Noodle-Box/Multimeter_TP1/README.md

# Multimeter---Team-Project-I
Multimeter for ENGG2800 - Team Project I

Features:
- DC Voltage
- AC Voltage
- Continuity (Current)
- Impedance

ENGG2800_Schematic_Multimeter
