Noodle-Box/Multimeter_TP1/PRODUCT_BOM.xlsx

Designator | Description | Quantity | Price each | Total price | Manufacturer | Manufacturer # | Supplier | Supplier # | RoHS link | RoHS notes
R22 | RESISTOR: 0.6 Watt/560 ohm/1%/Through Hole Resistor/Axial | 1 | $0.14 | $0.14 | Vishay Intertechnology | MRS25000C5607FCT | ETSG | Bin 02-23-01 | https://etsgstore.uqcloud.net/ | Compliance on Datasheet
R11,R16,R20 | RESISTOR: 0.6 Watt/1 Kohm/1%/Through Hole Resistor/Axial | 3 | $0.09 | $0.27 | Vishay Intertechnology | MRS25000C1001FCT | ETSG | Bin 02-25-02 | https://etsgstore.uqcloud.net/ | Compliance on Datasheet
R1,R2,R3,R6,R7,R9,R10,R13,R15,R18,R19 | RES 10K OHM 5% 1/4W AXIAL | 11 | $0.14 | $1.54 | Stackpole Electronics Inc | CF14JT10K0 | Digkey | CF14JT10K0CT-ND | https://www.digikey.com.au/en/products/detail/stackpole-electronics-inc/CF14JT10K0/1741265
R8,R14 | RESISTOR: 0.6 Watt/15 Kohm/1%/Through Hole Resistor/Axial | 2 | $0.16 | $0.32 | Vishay Intertechnology | MRS25000C51502FCT | Digikey | Bin 02-34-03 | https://etsgstore.uqcloud.net/ | Compliance on Datasheet
R4,R5 | RESISTOR: 0.6 Watt/27 Kohm/1%/Through Hole Resistor/Axial | 2 | $0.06 | $0.12 | Vishay Intertechnology | MRS25000C2702FCT | ETSG | Bin 02-36-03 | https://etsgstore.uqcloud.net/ | Compliance on Datasheet
R12,R17 | RESISTOR: 0.6 Watt/30 Kohm/1%/Through Hole Resistor/Axial | 2 | $0.04 | $0.08 | Vishay Intertechnology | MRS25000C3002FCT | ETSG | Bin 02-37-01 | https://etsgstore.uqcloud.net/ | Compliance on Datasheet
R21 | RESISTOR: 0.6 Watt/100 Kohm/1%/Through Hole Resistor/Axial | 1 | $0.02 | $0.02 | Vishay Intertechnology | MRS25000C1003FCT | ETSG | Bin 02-41-02 | https://etsgstore.uqcloud.net/ | Compliance on Datasheet
C1,C2 | CAPACITOR: Through Hole/Ceramic/100n/50V/High K / Y5U | 2 | $0.10 | $0.20 | Multicomp-Pro | MC0805Y104K5002.54MM | ETSG | Bin 03-12-02 | https://etsgstore.uqcloud.net/ | Compliance on Datasheet
- | BATTERIES : Battery / 1V5 / AA Style / Alkaline / 1.5v | 3 | 0.29 | 0.87 | Energizer Battery Company | 815 BULKJ2 | ETSG | Bin 28-09-02 | https://www.digikey.com.au/en/products/detail/energizer-battery-company/815-BULKJ2/11615679 | Same product from ETSG
- | BATT HOLDER AA 3 CELL 6" LEADS | 1 | 2.45 | 2.45 | Keystone Electronics | 2465 | Digikey | 36-2465-ND | https://www.digikey.com.au/en/products/detail/keystone-electronics/2465/303814
Batt1 | CONN HEADER R/A 2POS 2MM | 1 | 0.24 | 0.24 | JST Sales America Inc. | S2B-PH-K-S(LF)(SN) | Digikey | 455-1719-ND | https://www.digikey.com.au/en/products/detail/jst-sales-america-inc/S2B-PH-K-S-LF-SN/926626
- | CONN HOUSING PH 2POS 2MM WHITE | 1 | 0.14 | 0.14 | JST Sales America Inc. | PHR-2 | Digikey | 455-1165-ND | https://www.digikey.com.au/en/products/detail/jst-sales-america-inc/PHR-2/608607
- | CONNECTOR : JST PH - Crimp Terminal / Use Crimp Tool K143 | 2 | 0.02 | 0.04 | JST Sales America Inc. | SPH-002T-P0.5S | ETSG | Bin 08-50-03 | https://etsgstore.uqcloud.net/ | Compliance from Supplier
SW1,SW2,SW3,SW4,SW5 | SWITCH : PCB Mount / Tactile / 0.05A, 24VDC / SPST-NO | 6 | 0.14 | 0.84 | TE Connectivity | 1825910-6 | ETSG | Bin 04-69-03 | https://etsgstore.uqcloud.net/ | Compliance on Datasheet
SW6 | Slide Switch SPDT Through Hole | 1 | 1.25 | 1.25 | CUI Devices | MSS-102559-14A-D | Digikey | 2223-MSS-102559-14A-D-ND | https://www.digikey.com.au/en/products/detail/cui-devices/MSS-102559-14A-D/13978983
J1,J3 | 4mm Panel Mount Banana Socket - Red (BULK) | 1 | 6.84 | 6.84 | Staubli | 23.3000-22 | RS - Online | 404-171 | https://au.rs-online.com/web/p/banana-connectors/0404171
J2,J4 | 4mm Panel Mount Banana Socket - Black (BULK) | 1 | 6.84 | 6.84 | Staubli | 23.3000-21 | RS - Online | 404-137 | https://au.rs-online.com/web/p/banana-connectors/0404137/
U4 | IC MCU 8BIT 32KB FLASH 28DIP | 1 | 3.5 | 3.5 | Microchip Technology | ATMEGA328P-PU | Mouser | 556-ATMEGA328P-PU | https://au.mouser.com/ProductDetail/Microchip-Technology-Atmel/ATMEGA328P-PU
U1 | IC OPAMP JFET 4 CIRCUIT 14DIP | 1 | 1.46 | 1.46 | NJR Corporation/NJRC | NJM064D | Mouser | 513-NJM064D | https://au.mouser.com/ProductDetail/NJR/NJM064D
U6 | SEEEDIUNO XIAO - SAMD21 Cortex M0+ | 1 | 5.4 | 5.4 | Seeeduino Studio | Seeeduino XIAO | Seeeduino Studio | Seeeduino XIAO | https://www.seeedstudio.com/Seeeduino-XIAO-Arduino-Microcontroller-SAMD21-Cortex-M0+-p-4426.html
U3 | Adafruit 6-pin AVR ISP Breadboard Adapter Mini Kit | 1 | 0.95 | 0.95 | Adafruit | Adafruit 6-pin AVR ISP | Adafruit | Adafruit 6-pin AVR ISP | https://www.adafruit.com/product/1465
U2 | Pololu 3.3V Step-Up Voltage Regulator U1V10F3 | 1 | 7.35 | 7.35 | Pololu | U1V10F3 | Pololu | U1V10F3 | https://www.pololu.com/product/2563
DISP1 | Small Size Blue LCD Bezel 20x4 Arduino Library Character Display Module | 1 | 6.26 | 6.26 | EastRising | ERM2004SBS-3 | BuyDisplay | ERM2004SBS-3 | https://www.buydisplay.com/small-size-blue-lcd-bezel-20x4-arduino-library-character-display-module
U5 | ADS1115 16BIT ADC 4CH PROG GAIN | 1 | 20.18 | 20.18 | Adafruit | 1085 | Mouser | 485-1085 | https://au.mouser.com/ProductDetail/Adafruit/1085?qs=GURawfaeGuCW8oufi8WauA%3D%3D
- | PCB Pinecone | 1 | $32.50 | $32.50
 |  |  | Total: | $99.80
