Noodle-Box/Multimeter_TP1/Multimeter Schematics.pdf

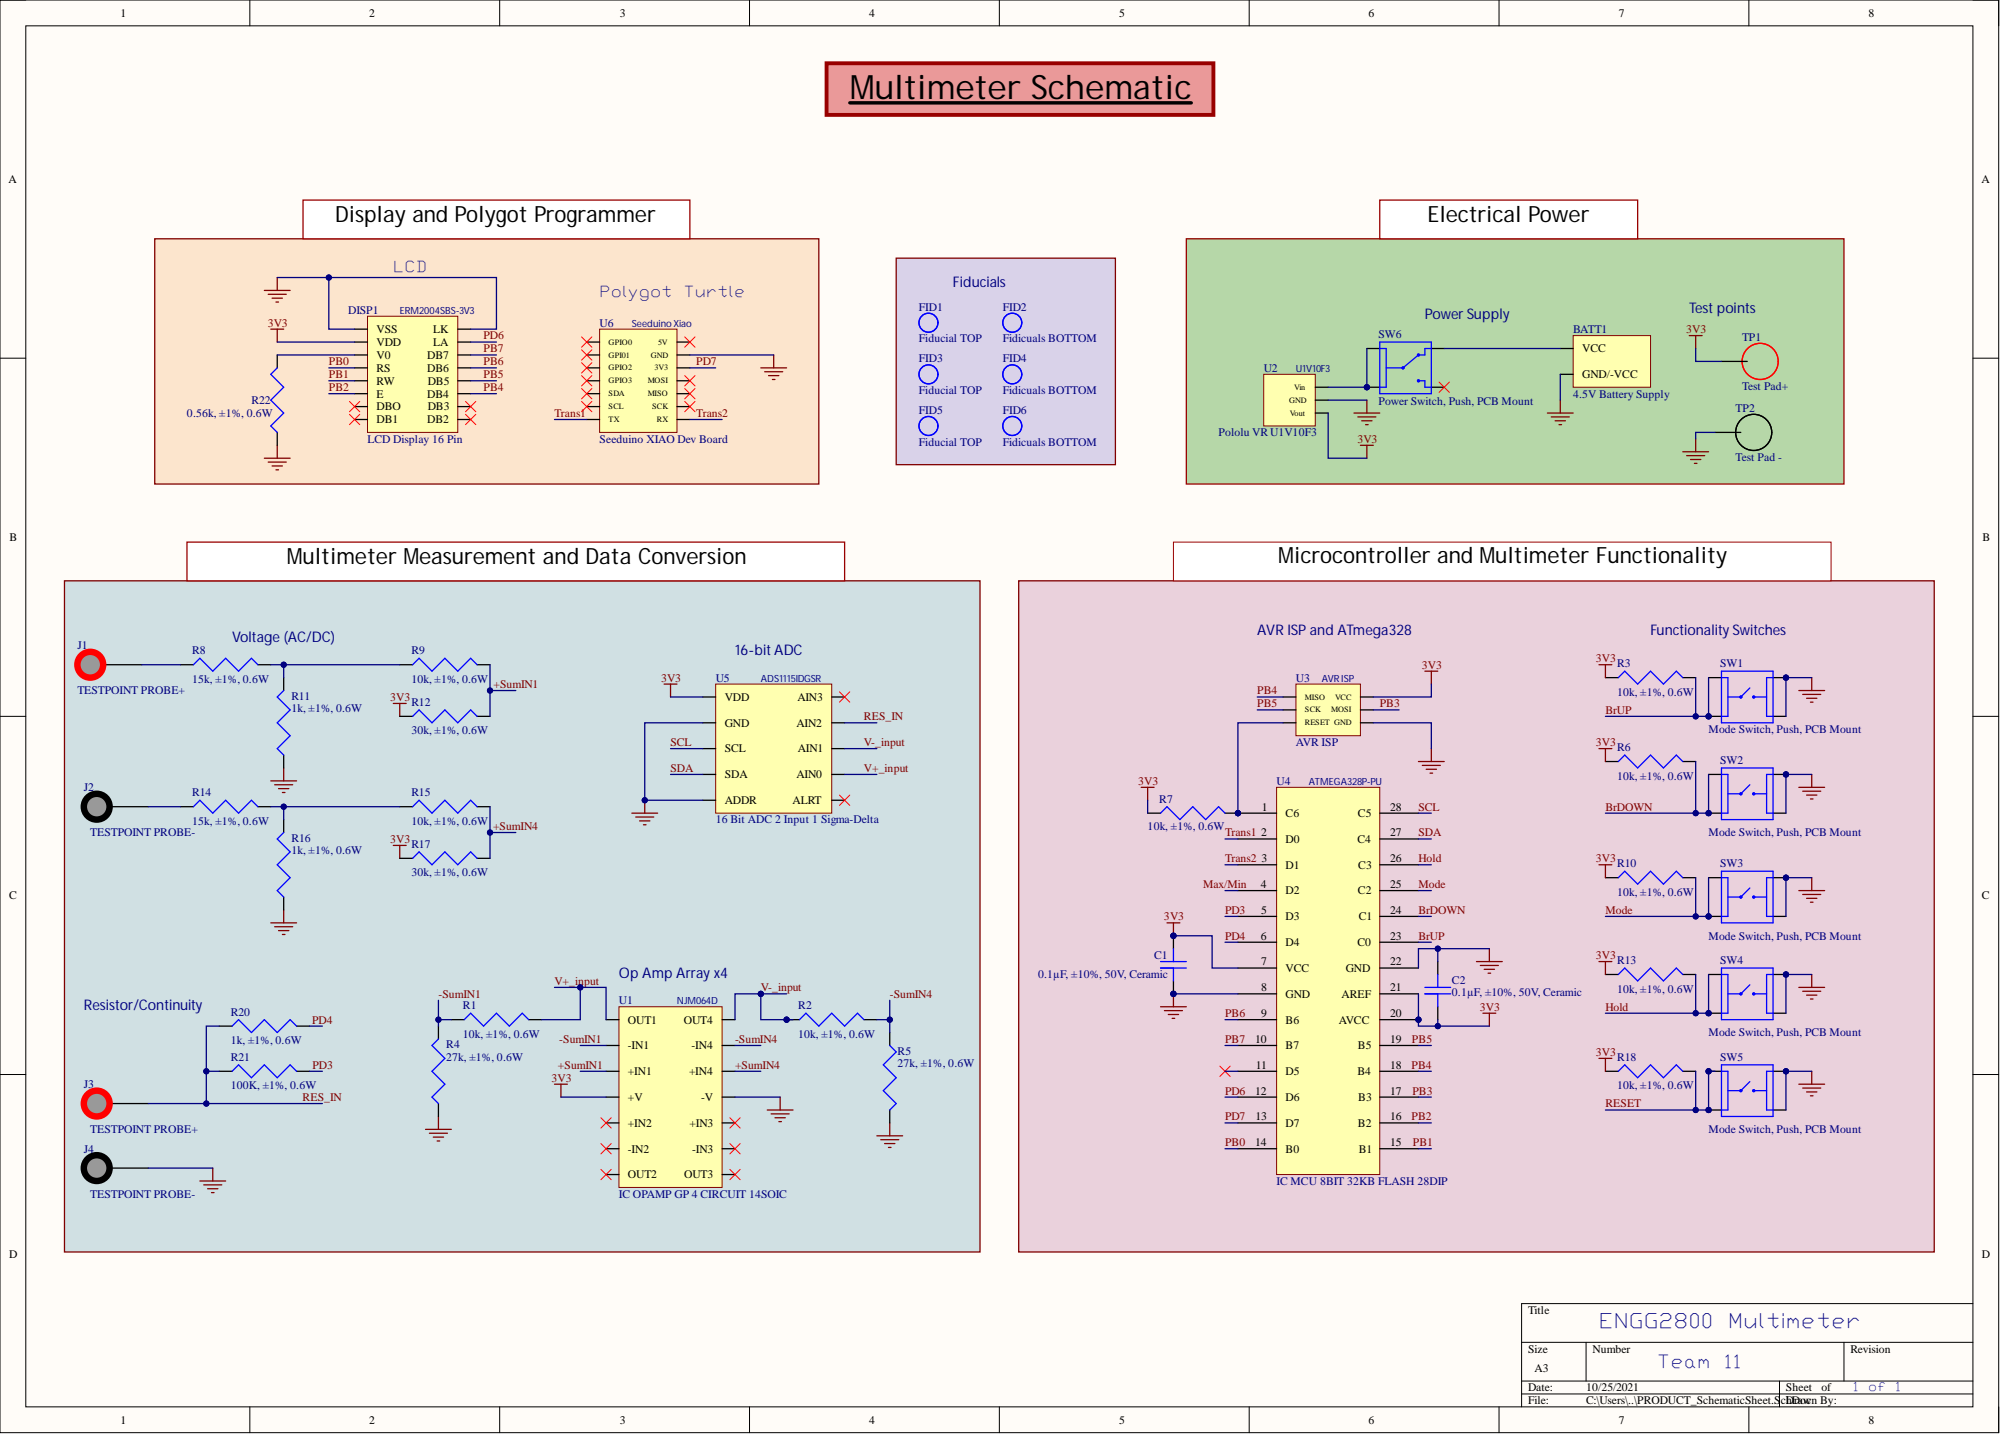
[picture p1: page 1]

Power Switch, Push, PCB Mount

Mode Switch, Push, PCB Mount

16 Bit ADC 2 Input 1 Sigma-Delta

IC OPAMP GP 4 CIRCUIT 14SOIC
