Noodle-Box/Multimeter_TP1/Multimeter Layers (Top and Bottom).pdf

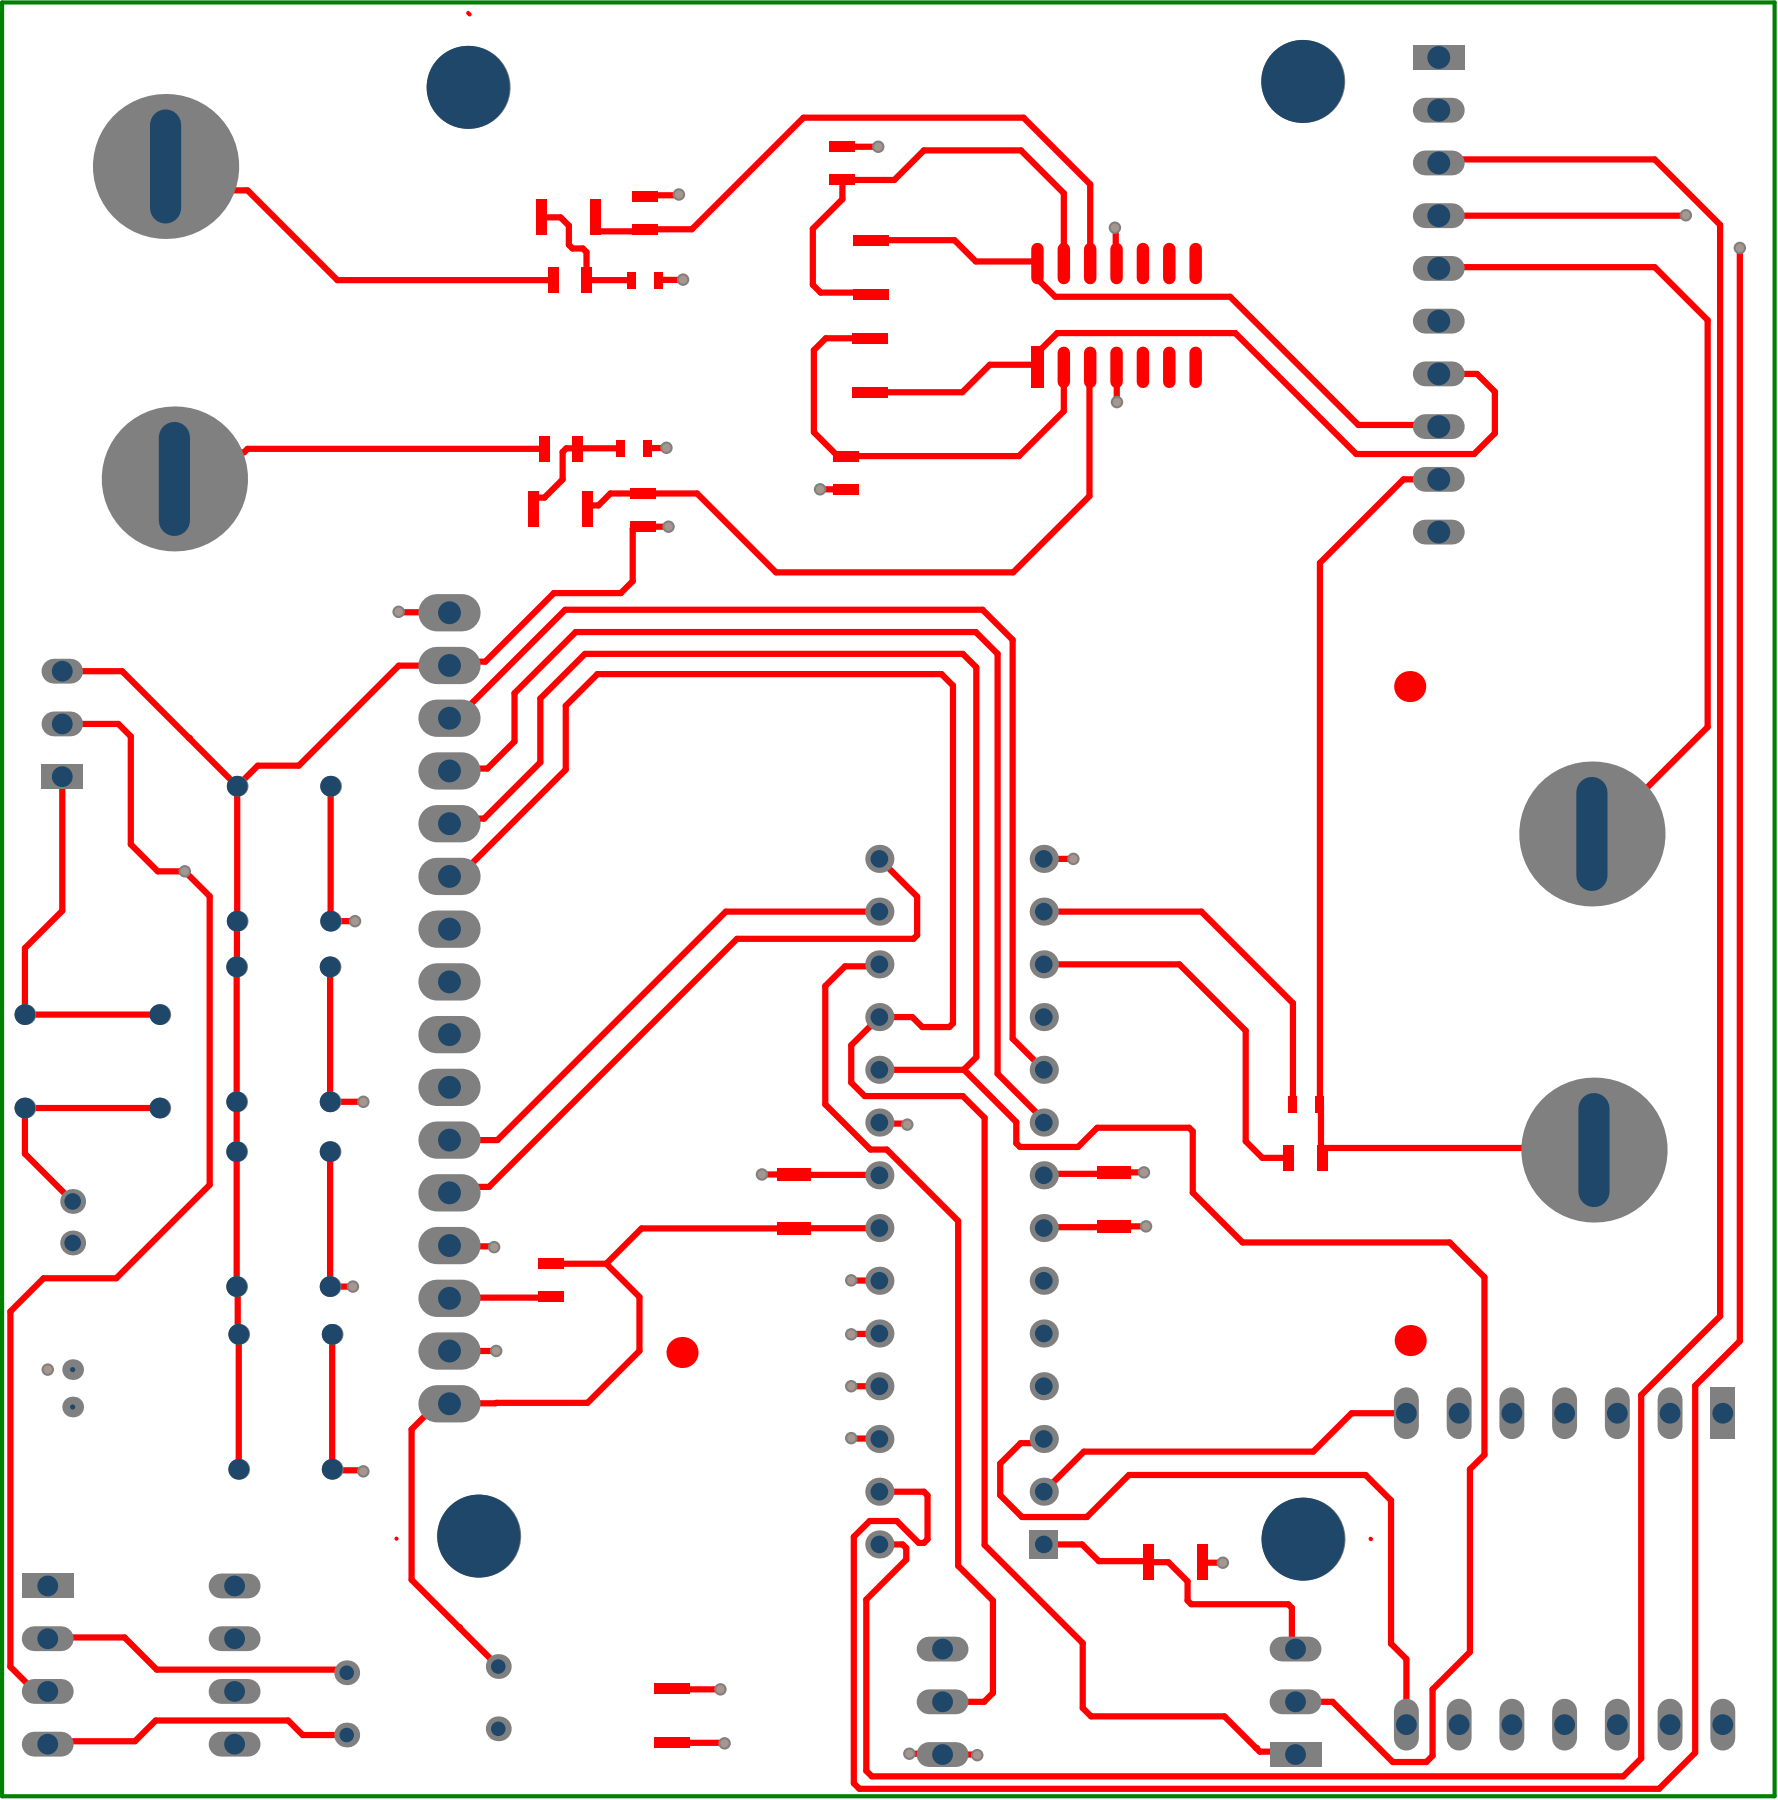
[picture p2: page 1]

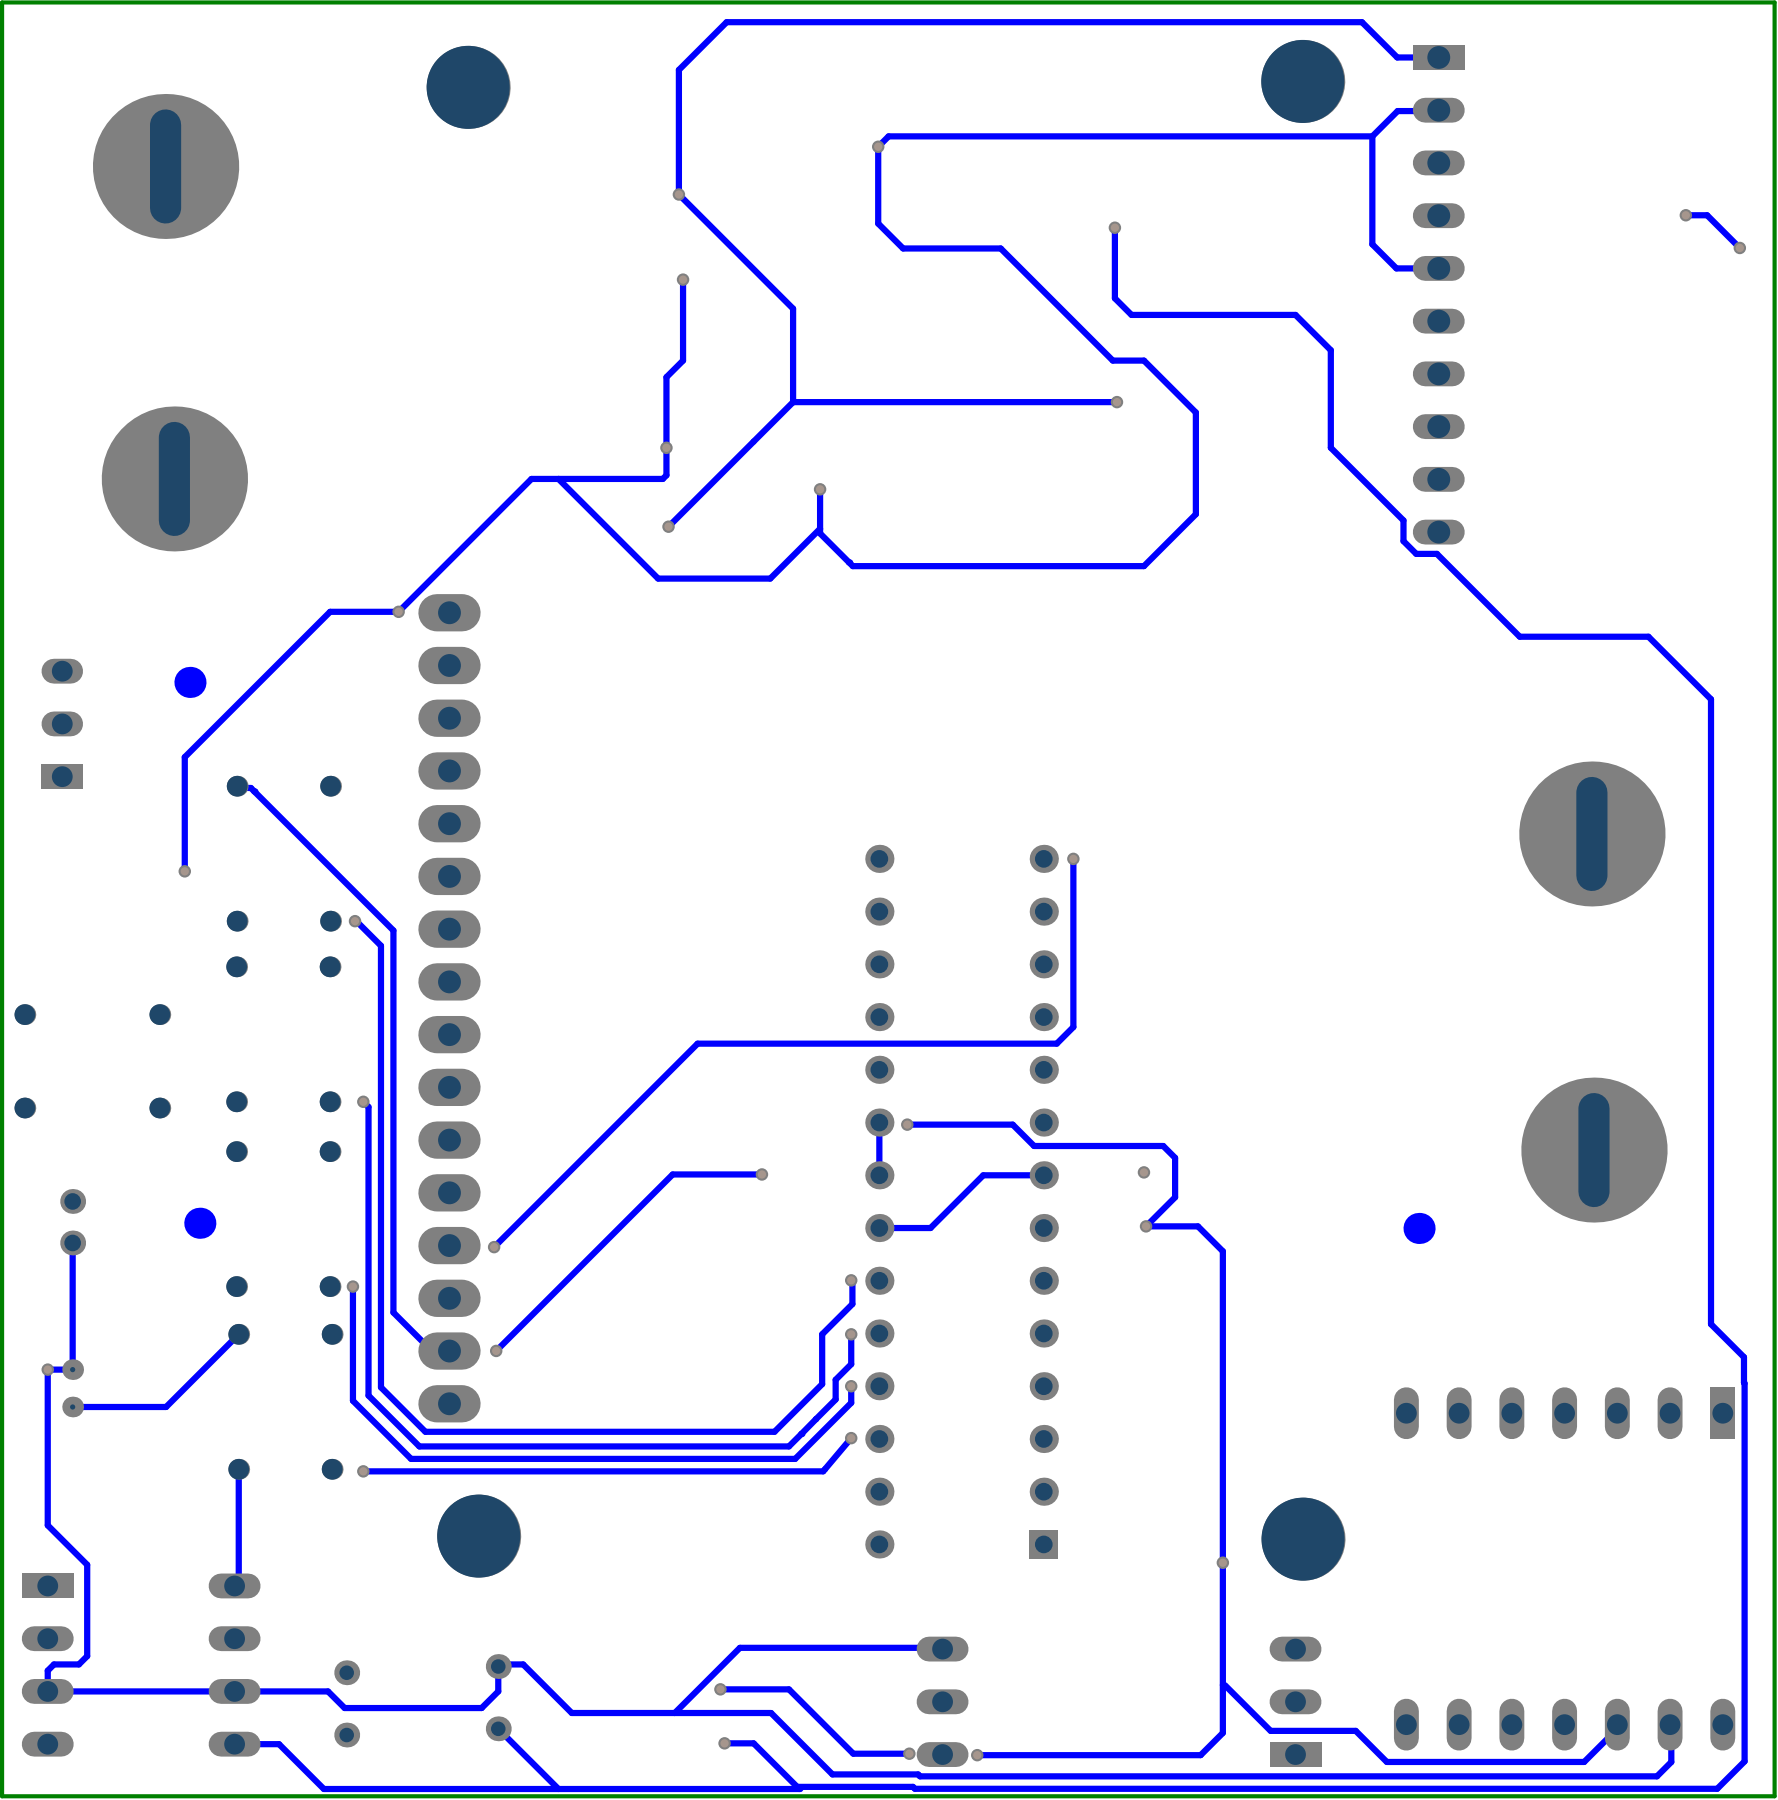
[picture p3: page 2]
