Noodle-Box/Multimeter_TP1/(commit log)

2021-09-22 Committing C file used to test UART, I2C and interaction with ADC. Can successfully use diff. mode on ADC to measure voltages. Uses libraries "i2cmaster.h" and "twimaster.c"
2021-09-29 Created a file that is the current GUI with a class based approach.
2021-10-02 basic lCD code, similar to what was in the video. Buttons needs to be adjusted to new port
2021-10-02 Code for LCD, what was displayed in demo with rx and tx port freed and buttons on pinc0 and pinc1
2021-10-02 LCD code and libraries with backlight adjustment working (buttons on pc0 and pc1) and lcd connected to portB
2021-10-05 Adjusted brightness bar to be vertical with 5 distinct mode. created seperate measuring screens that can be changed using a button
2021-10-05 created vertical brightness bar and measurment screens that can be changed using buttons on port C
2021-10-05 fixed issue with mode change, vertical brightness bar implemented
    [main.c]
2021-10-05 Completely new gui with partial pyserial implementation, can select ports but unsure if they actually connect and having problems with readSerial
    [GUIV2I1.py]
2021-10-06 adc libraries
2021-10-06 Updated adc file
2021-10-06 adding i2c/adc
2021-10-07 adjusted demo code for measuring AC/DC voltage
2021-10-07 demo day ADC DC/AC code
2021-10-15 made changes to gui but primarily interrupts have been set up on button presses on LCD
